CyberSortir936/stm32digitalReverb/schematic.pdf

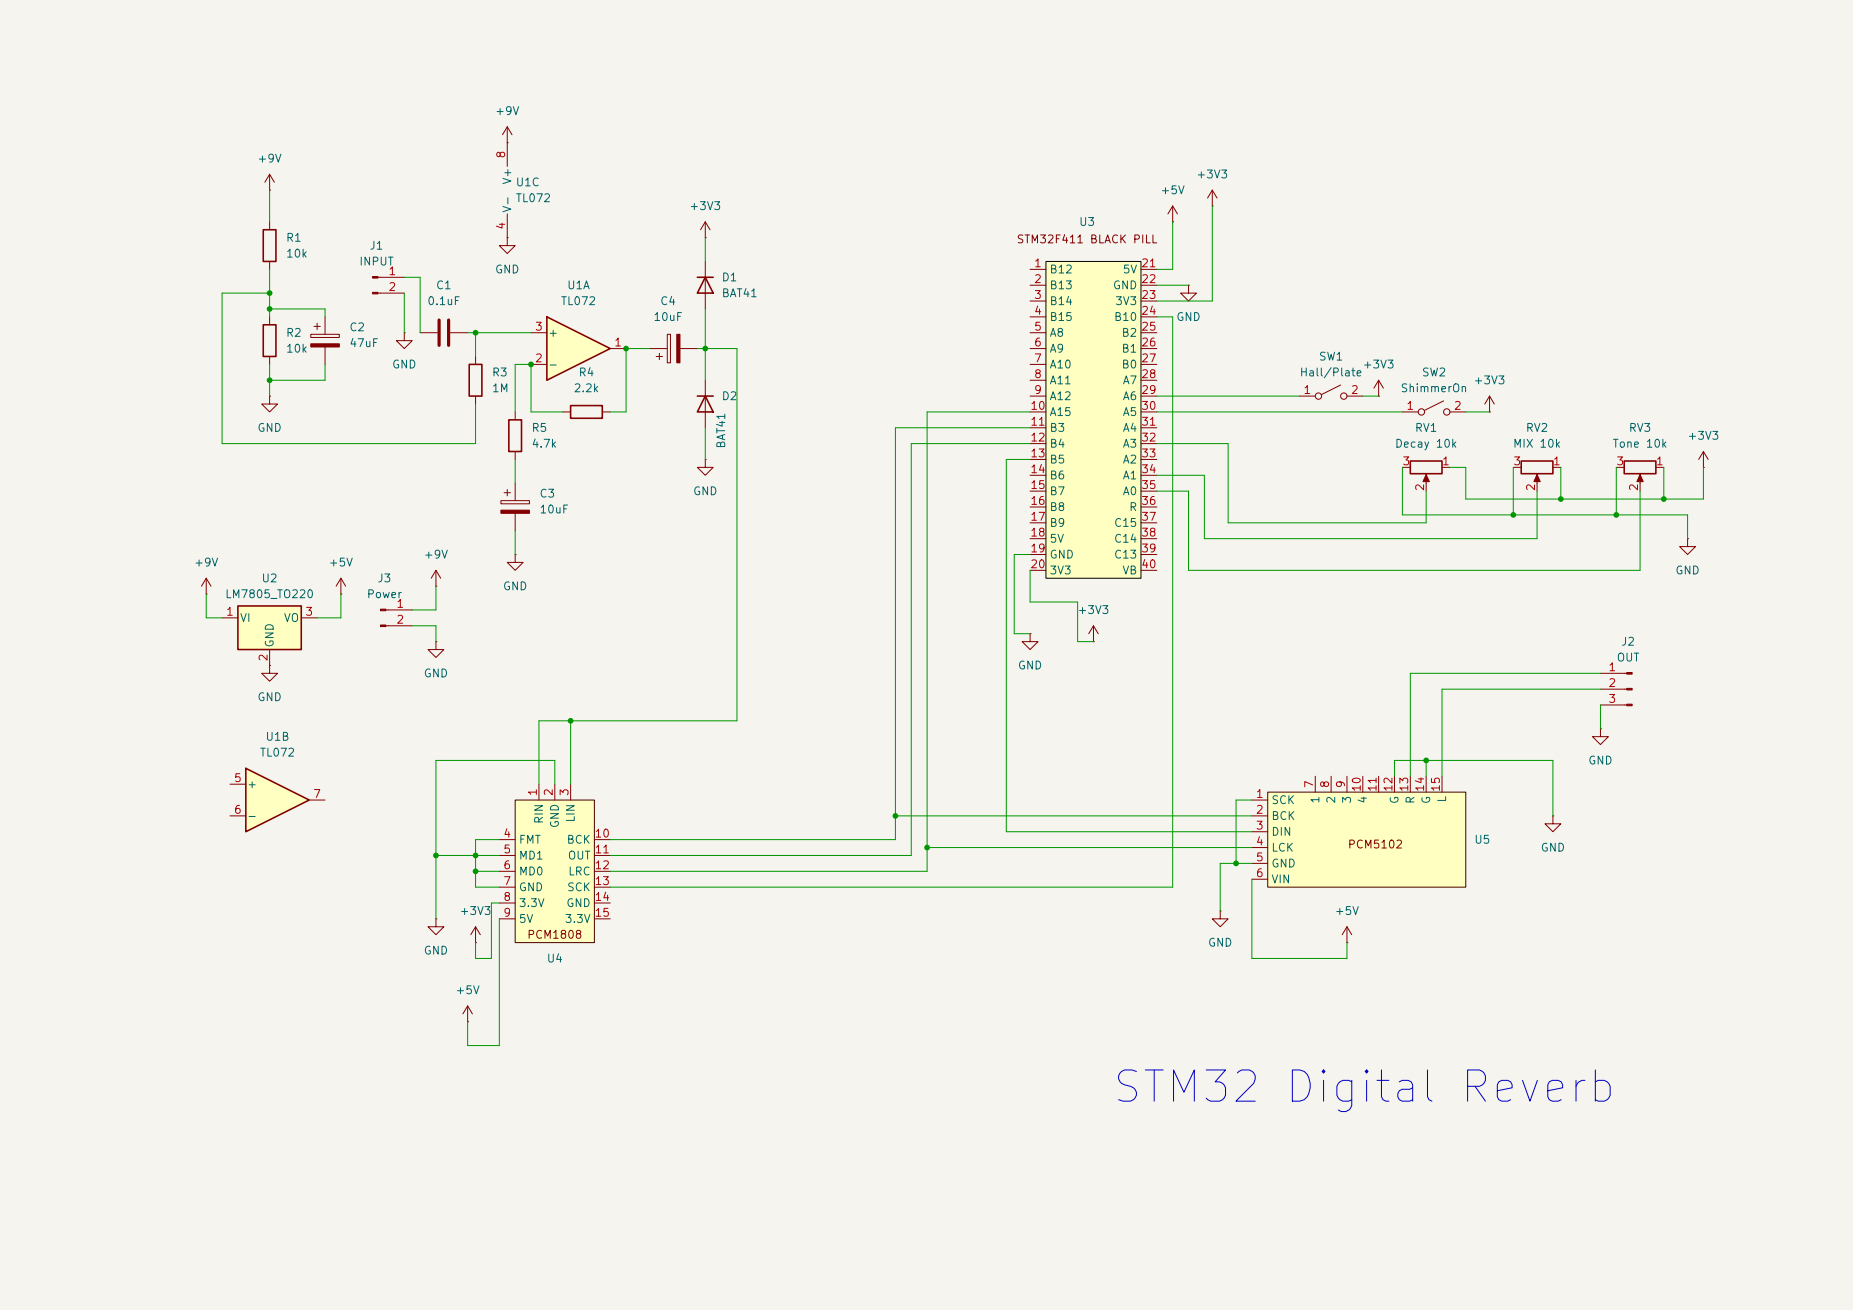
[picture p1: page 1]
