CyberSortir936/stm32digitalReverb/Core/Src/main.c

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
/* Includes ------------------------------------------------------------------*/
#include "main.h"

/* USER CODE BEGIN Includes */
#include "stm32f4xx_ll_bus.h"
#include "stm32f4xx_ll_gpio.h"
#include "stm32f4xx_ll_dma.h"
#include "stm32f4xx_ll_spi.h"

#include "reverb_dsp.h"
/* USER CODE END Includes */

ADC_HandleTypeDef hadc1;
DMA_HandleTypeDef hdma_adc1;

I2S_HandleTypeDef hi2s3;
DMA_HandleTypeDef hdma_i2s3_ext_rx;
DMA_HandleTypeDef hdma_spi3_tx;

/* USER CODE BEGIN PV */
int32_t dc_offset_filter = 0;

// --- Стан системи ---
volatile uint8_t alg_mode = 1;       // 1 = Plate, 0 = Hall
volatile uint8_t shimmer_active = 0; // 1 = Shimmer ON

// --- Plate buffers ---
int16_t p_diff_bufs[4][300]; 
int16_t p_tank_ap_buf[600];
int16_t p_main_delay_buf[15000];

// --- Hall buffers ---
int16_t h_pre_delay_buf[2400];
int16_t h_comb_bufs[8][2000];
const uint16_t h_comb_sizes[8] = {1557, 1617, 1491, 1422, 1277, 1356, 1188, 1116}; 
int16_t h_ap_bufs[4][600]; 
const uint16_t h_ap_sizes[4] = {225, 556, 441, 341};

// --- Reverberators structures ---
Plate_Reverb myPlate;
Hall_Reverb  myHall;

// ADC and audio buffers
volatile uint16_t adc_values[3];
uint32_t mix_val = 0, decay_val = 0, tone_val = 0;
#define AUDIO_BUF_SIZE 512
uint16_t rx_buf[AUDIO_BUF_SIZE];
uint16_t tx_buf[AUDIO_BUF_SIZE];
/* USER CODE END PV */

void SystemClock_Config(void);
void PeriphCommonClock_Config(void);
static void MX_GPIO_Init(void);
static void MX_DMA_Init(void);
static void MX_I2S3_Init(void);
static void MX_ADC1_Init(void);
/* USER CODE BEGIN 0 */


void Read_Pots_And_Smooth(void) {

  
  uint32_t raw_decay = adc_values[0]; // Decay
  uint32_t raw_mix   = adc_values[1]; // Mix
  uint32_t raw_tone  = adc_values[2]; // Tone

  // Dead zones
  if (raw_mix < 50) raw_mix = 0;
  else if (raw_mix > 4040) raw_mix = 4095;

  if (raw_decay < 50) raw_decay = 0;
  else if (raw_decay > 4040) raw_decay = 4095;

  if (raw_tone < 50) raw_tone = 0;
  else if (raw_tone > 4040) raw_tone = 4095;

  // Smoothing values
  mix_val   = ((mix_val   * 15) + raw_mix) >> 4;
  decay_val = ((decay_val * 15) + raw_decay) >> 4;
  tone_val  = ((tone_val  * 15) + raw_tone) >> 4;
}

void Update_Physical_Controls(void) {
    static uint32_t last_check_time = 0;
    if (HAL_GetTick() - last_check_time > 20) {
        // PA6 - plate/hall, PA5 - shimmer on/off
        alg_mode = LL_GPIO_IsInputPinSet(GPIOA, LL_GPIO_PIN_6);
        //alg_mode = 1;
        
        // For some reason shimmer has artifacts when it is activated on HIGH
        shimmer_active = !LL_GPIO_IsInputPinSet(GPIOA, LL_GPIO_PIN_5); 
        
        last_check_time = HAL_GetTick();
    }
}

// Only left channel is processed and copied to both channels
void Process_Audio_Block(uint32_t start_idx, uint32_t end_idx) {

  int16_t wet_out = 0;

  int16_t current_mix  = (int16_t)((mix_val   * 32767) >> 12);
  int16_t current_fb = (int16_t)((decay_val * 32600) >> 12);
  int16_t current_damp = (int16_t)((tone_val  * 32767) >> 12);
  
  // Hall struct update
  myHall.damping_filter.damping = 32767 - current_damp;
  for(int k=0; k<8; k++) myHall.combs[k].feedback = current_fb;
  // Plate
  myPlate.damping_filter.damping = 32767 - current_damp;
  myPlate.decay = current_fb;

  for (uint32_t i = start_idx; i < end_idx; i += 4) {
    int16_t dry_mono = (int16_t)rx_buf[i];

    // Input attenuation
    int16_t input_to_reverb = dry_mono / 4; 

    // Algorithm select
    if (alg_mode == 1) {
            wet_out = Plate_Process(&myPlate, input_to_reverb, shimmer_active);
        } else {
            wet_out = Hall_Process(&myHall, input_to_reverb, shimmer_active);
        }

    int32_t wet_compensated = (int32_t)wet_out * 3; 

    // Mix
    int32_t final_out = (((int32_t)dry_mono * (32767 - current_mix)) >> 15) + 
                        ((wet_compensated * current_mix) >> 15);

    // Limiter
    if (final_out > 32767) final_out = 32767;
    if (final_out < -32768) final_out = -32768;

    // Output dual mono
    tx_buf[i]   = (uint16_t)final_out;
    tx_buf[i+1] = rx_buf[i+1];
    tx_buf[i+2] = (uint16_t)final_out;
    tx_buf[i+3] = rx_buf[i+3]; 
    }
}
/* USER CODE END 0 */

/**
  * @brief  The application entry point.
  * @retval int
  */
int main(void)
{

  /* MCU Configuration--------------------------------------------------------*/

  /* Reset of all peripherals, Initializes the Flash interface and the Systick. */
  HAL_Init();

  /* Configure the system clock */
  SystemClock_Config();

  /* Configure the peripherals common clocks */
  PeriphCommonClock_Config();

  /* Initialize all configured peripherals */
  MX_GPIO_Init();
  MX_DMA_Init();
  MX_I2S3_Init();
  MX_ADC1_Init();
  /* USER CODE BEGIN 2 */
  // --- Plate init ---
  for(int i=0; i<4; i++) Delay_Filter_Init(&myPlate.diffuser[i], p_diff_bufs[i], 300-(i*40), 16384);
  Delay_Filter_Init(&myPlate.tank_ap, p_tank_ap_buf, 600, 18000);
  Delay_Line_Init(&myPlate.main_delay, p_main_delay_buf, 15000);
  LPF_Init(&myPlate.damping_filter, 16000);

  // --- Hall init ---
  Delay_Line_Init(&myHall.pre_delay, h_pre_delay_buf, 1440);
  for(int i=0; i<8; i++) Delay_Filter_Init(&myHall.combs[i], h_comb_bufs[i], h_comb_sizes[i], 28000);
  for(int i=0; i<4; i++) Delay_Filter_Init(&myHall.allpasses[i], h_ap_bufs[i], h_ap_sizes[i], 18000);
  LPF_Init(&myHall.damping_filter, 12000);

  // Start ADC
  HAL_ADC_Start_DMA(&hadc1, (uint32_t*)adc_values, 3);
  HAL_NVIC_DisableIRQ(DMA2_Stream0_IRQn); // Disabling ADC interrupt

  LL_APB1_GRP1_EnableClock(LL_APB1_GRP1_PERIPH_SPI3);
  HAL_NVIC_DisableIRQ(DMA1_Stream0_IRQn);
  HAL_NVIC_DisableIRQ(DMA1_Stream5_IRQn);

  LL_I2S_Disable(SPI3);
  LL_I2S_Disable(I2S3ext);

  LL_DMA_SetDataLength(DMA1, LL_DMA_STREAM_0, AUDIO_BUF_SIZE);
  LL_DMA_ConfigAddresses(DMA1, LL_DMA_STREAM_0, (uint32_t)&I2S3ext->DR, (uint32_t)rx_buf, LL_DMA_DIRECTION_PERIPH_TO_MEMORY);
  LL_DMA_SetDataLength(DMA1, LL_DMA_STREAM_5, AUDIO_BUF_SIZE);
  LL_DMA_ConfigAddresses(DMA1, LL_DMA_STREAM_5, (uint32_t)tx_buf, (uint32_t)&SPI3->DR, LL_DMA_DIRECTION_MEMORY_TO_PERIPH);

  LL_I2S_EnableDMAReq_RX(I2S3ext);
  LL_I2S_EnableDMAReq_TX(SPI3);
  LL_DMA_EnableStream(DMA1, LL_DMA_STREAM_0);
  LL_DMA_EnableStream(DMA1, LL_DMA_STREAM_5);
  LL_I2S_Enable(I2S3ext);
  LL_I2S_Enable(SPI3);
  /* USER CODE END 2 */

  /* Infinite loop */
  /* USER CODE BEGIN WHILE */
  while (1)
  {
    if (LL_DMA_IsActiveFlag_HT0(DMA1))
    {
        LL_DMA_ClearFlag_HT0(DMA1); 
        
        Update_Physical_Controls();
        Read_Pots_And_Smooth(); 
        Process_Audio_Block(0, AUDIO_BUF_SIZE / 2);
    }

    if (LL_DMA_IsActiveFlag_TC0(DMA1))
    {
        LL_DMA_ClearFlag_TC0(DMA1);    
        Read_Pots_And_Smooth();
        Process_Audio_Block(AUDIO_BUF_SIZE / 2, AUDIO_BUF_SIZE);
    }
    /* USER CODE END WHILE */

    /* USER CODE BEGIN 3 */
  }
  /* USER CODE END 3 */
}

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
