CyberSortir936/stm32digitalReverb/stm32LLreverb.ioc

Mcu.UserName=STM32F411CEUx
PA0-WKUP.Signal=ADCx_IN0
PA1.Signal=ADCx_IN1
PA13.Signal=SYS_JTMS-SWDIO
PA14.Signal=SYS_JTCK-SWCLK
PA15.Signal=I2S3_WS
PA2.Signal=I2S_CKIN
PA3.Signal=ADCx_IN3
PA5.Signal=GPIO_Input
PA6.Signal=GPIO_Input
PA8.Signal=RCC_MCO_1
PB10.Signal=I2S3_MCK
PB13.Signal=GPIO_Input
PB3.Signal=I2S3_CK
PB4.Signal=I2S3_ext_SD
PB5.Signal=I2S3_SD
