CyberSortir936/stm32digitalReverb/(commit log)

2026-02-23 Configured ADC and added analog input cascade
2026-03-22 Configured onboard ADC for Decay, Tone and Mix control
2026-03-22 ADC now controls Decay, Tone and Blend
2026-03-23 Filter code refactor and dual mono
2026-03-24 code refactory and proper hall reverb algorithm
2026-03-24 added shimmer to hall
2026-03-25 Plate reverb addition and final refactor
2026-04-10 Added hardware schematic
2026-04-29 Minor Schematic and Readme fix
    [main.c]
2026-05-22 Changed Shimmer GPIO and fixed a little
    [main.c, reverb_dsp.c, stm32LLreverb.ioc]
